blocktrron/serial-hub/serial-hub.kicad_pcb

## KiCad design serial-hub.kicad_pcb (2023-05-25)

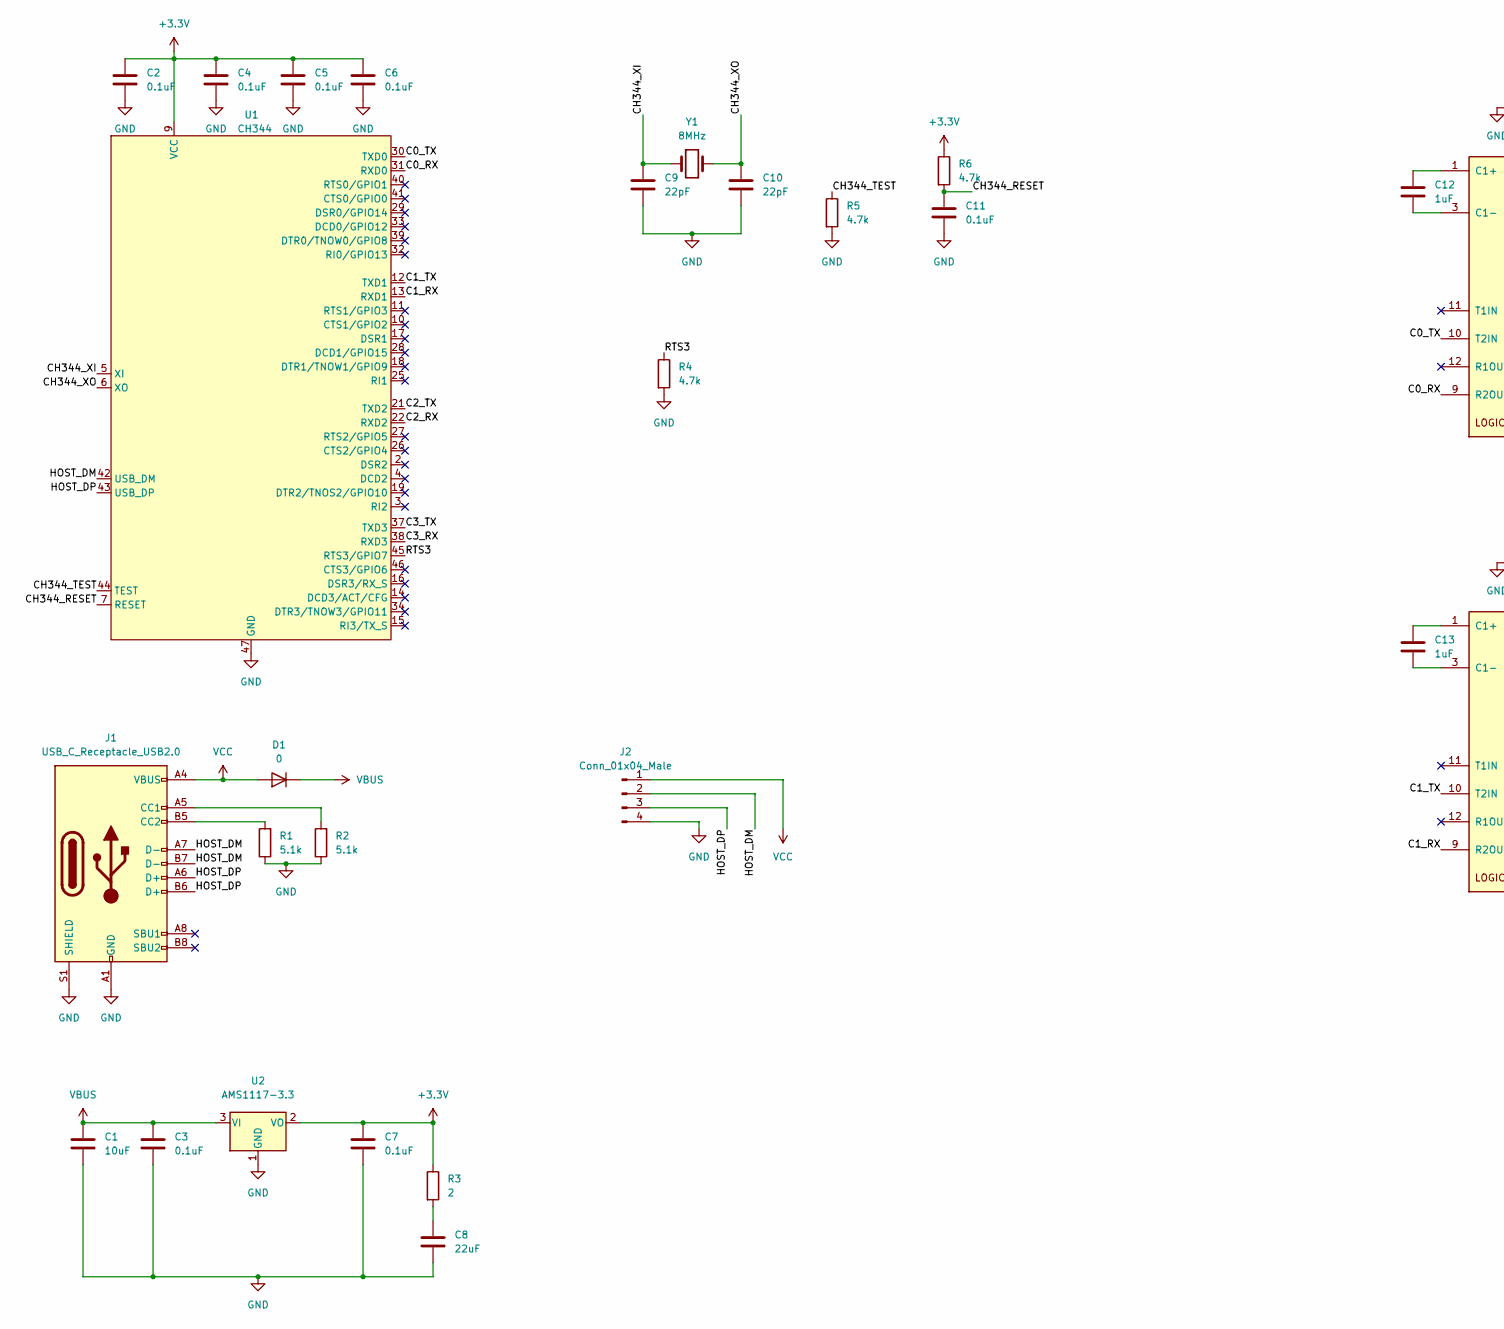
[picture p1: schematic serial-hub.kicad_sch, part in row 1, column 1]

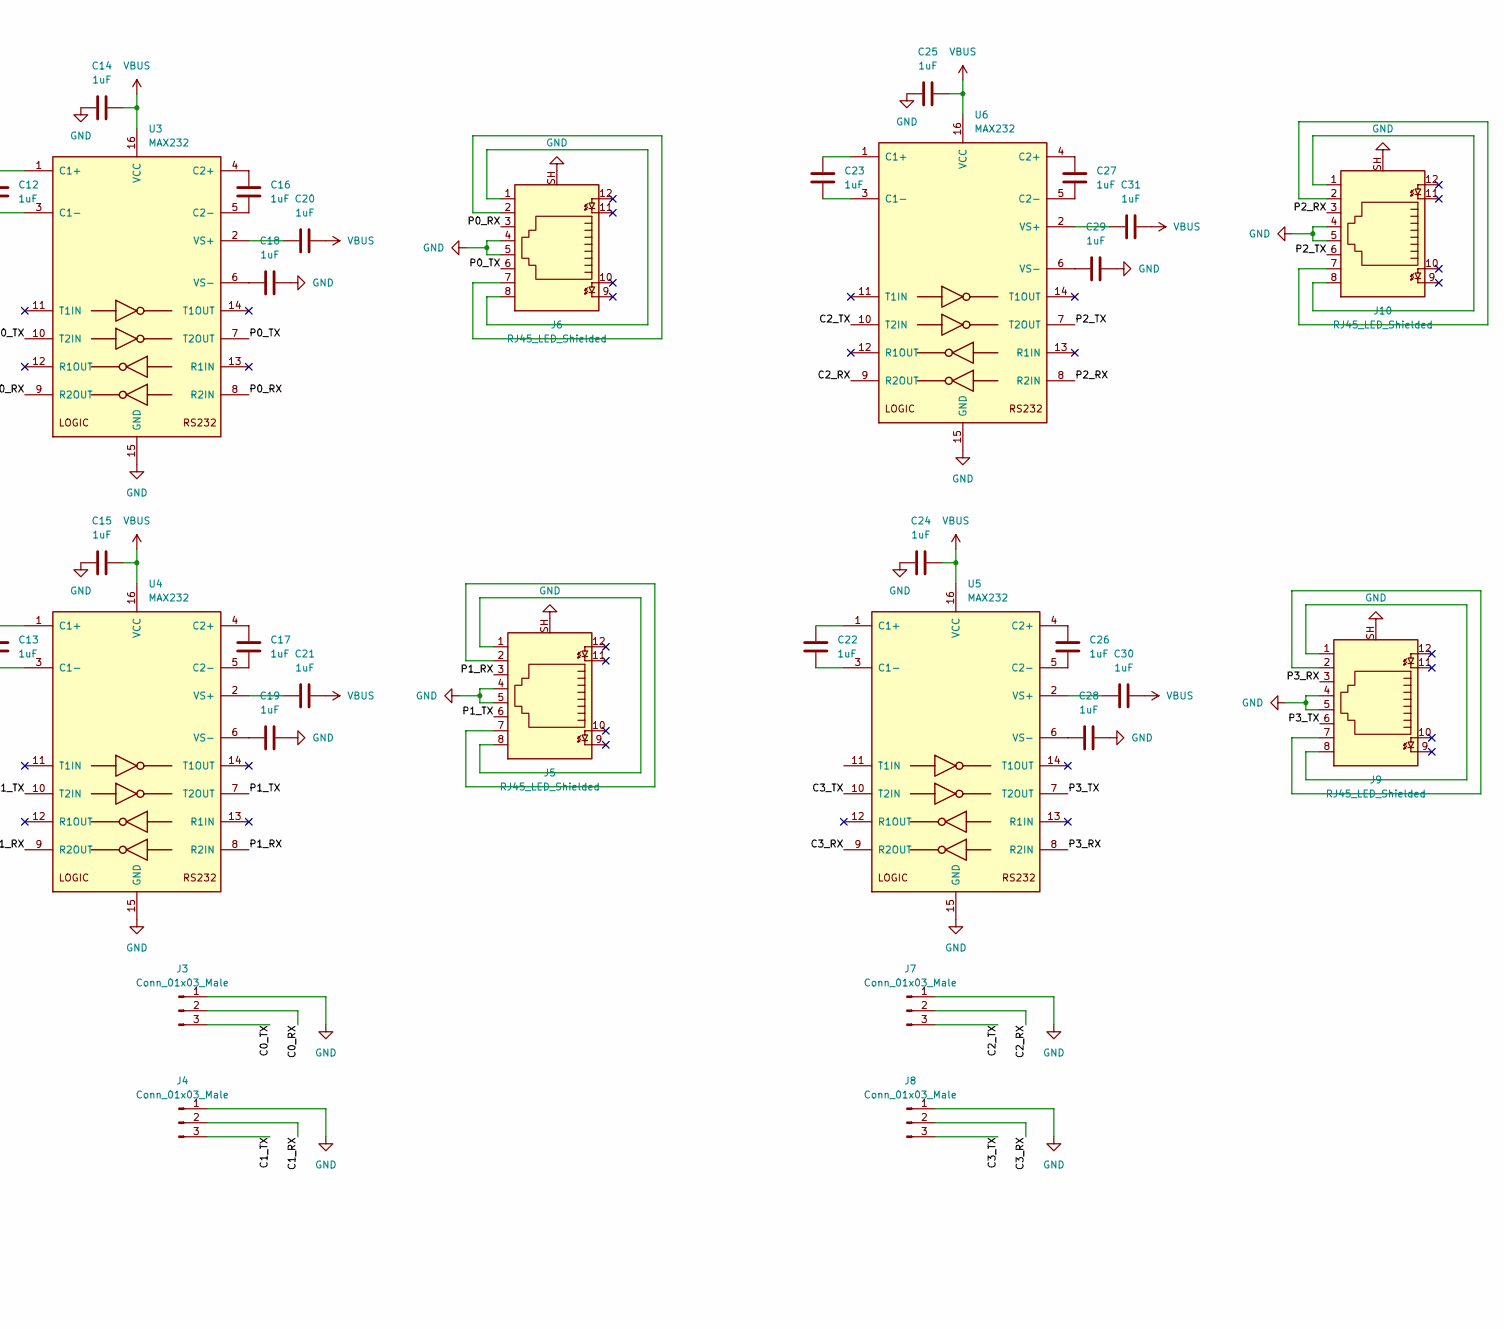
[picture p2: schematic serial-hub.kicad_sch, part in row 1, column 2]

Parts:
C1: 10uF; C_0603_1608Metric; LCSC C96446
C2, C3, C4, C5, C6, C7, C11: 0.1uF; C_0603_1608Metric; LCSC C14663
C8: 22uF; C_0805_2012Metric; LCSC C45783
C9, C10: 22pF; C_0402_1005Metric; LCSC C1555
C12, C13, C14, C15, C16, C17, C18, C19, C20, C21, C22, C23, C24, C25, C26, C27, C28, C29, C30, C31: 1uF; C_0603_1608Metric; LCSC C15849
D1: 0; D_SOD-123; LCSC C8598
J1: USB_C_Receptacle_USB2.0; USB_C_Receptacle_XKB_U262-16XN-4BVC11; LCSC C2988369
J2: Conn_01x04_Male; PinHeader_1x04_P2.54mm_Vertical
J3, J4, J7, J8: Conn_01x03_Male; PinHeader_1x03_P2.54mm_Vertical
J5, J6, J9, J10: RJ45_LED_Shielded; RJ45_Amphenol_54602-x08_Horizontal; LCSC C2847314
R1, R2: 5.1k; R_0402_1005Metric; LCSC C25905
R3: 2; R_0603_1608Metric; LCSC C22977
R4, R5, R6: 4.7k; R_0402_1005Metric; LCSC C25900
U1: CH344; LQFP-48_7x7mm_P0.5mm; LCSC C2988084
U2: AMS1117-3.3; SOT-223-3_TabPin2; LCSC C6186
U3, U4, U5, U6: MAX232; SOIC-16_3.9x9.9mm_P1.27mm; LCSC C26860
Y1: 8MHz; Crystal_SMD_5032-2Pin_5.0x3.2mm; LCSC C115962

Connections:
+3.3V: C2.1, C4.1, C5.1, C6.1, C7.1, R3.1, R6.1, U1.9 (VCC), U1.24 (VCC), U1.36 (VCC), U1.48 (VCC), U2.2 (VO)
/C0_RX: J3.2, U1.31 (RXD0), U3.9 (R2OUT)
/C0_TX: J3.3, U1.30 (TXD0), U3.10 (T2IN)
/C1_RX: J4.2, U1.13 (RXD1), U4.9 (R2OUT)
/C1_TX: J4.3, U1.12 (TXD1), U4.10 (T2IN)
/C2_RX: J7.2, U1.22 (RXD2), U6.9 (R2OUT)
/C2_TX: J7.3, U1.21 (TXD2), U6.10 (T2IN)
/C3_RX: J8.2, U1.38 (RXD3), U5.9 (R2OUT)
/C3_TX: J8.3, U1.37 (TXD3), U5.10 (T2IN)
/CH344_RESET: C11.1, R6.2, U1.7 (RESET)
/CH344_TEST: R5.1, U1.44 (TEST)
/CH344_XI: C9.1, U1.5 (XI), Y1.1
/CH344_XO: C10.1, U1.6 (XO), Y1.2
/HOST_DM: J1.A7 (D-), J1.B7 (D-), J2.2, U1.42 (USB_DM)
/HOST_DP: J1.A6 (D+), J1.B6 (D+), J2.3, U1.43 (USB_DP)
/P0_RX: J6.3, U3.8 (R2IN)
/P0_TX: J6.6, U3.7 (T2OUT)
/P1_RX: J5.3, U4.8 (R2IN)
/P1_TX: J5.6, U4.7 (T2OUT)
/P2_RX: J10.3, U6.8 (R2IN)
/P2_TX: J10.6, U6.7 (T2OUT)
/P3_RX: J9.3, U5.8 (R2IN)
/P3_TX: J9.6, U5.7 (T2OUT)
/RTS3: R4.1, U1.45 (RTS3/GPIO7)
GND: C1.2, C2.2, C3.2, C4.2, C5.2, C6.2, C7.2, C8.2, C9.2, C10.2, C11.2, C14.1, C15.1, C18.2, C19.2, C24.1, C25.1, C28.2, C29.2, J1.A1 (GND), J1.A12 (GND), J1.B1 (GND), J1.B12 (GND), J1.S1 (SHIELD), J2.4, J3.1, J4.1, J5.4, J5.5, J5.SH, J6.4, J6.5, J6.SH, J7.1, J8.1, J9.4, J9.5, J9.SH, J10.4, J10.5, J10.SH, R1.1, R2.1, R4.2, R5.2, U1.8 (GND), U1.20 (GND), U1.23 (GND), U1.35 (GND), U1.47 (GND), U2.1 (GND), U3.15 (GND), U4.15 (GND), U5.15 (GND), U6.15 (GND)
unnamed: C8.1, R3.2
unnamed: C12.1, U3.1 (C1+)
unnamed: C12.2, U3.3 (C1-)
unnamed: C13.1, U4.1 (C1+)
unnamed: C13.2, U4.3 (C1-)
unnamed: C16.1, U3.4 (C2+)
unnamed: C16.2, U3.5 (C2-)
unnamed: C17.1, U4.4 (C2+)
unnamed: C17.2, U4.5 (C2-)
unnamed: C18.1, U3.6 (VS-)
unnamed: C19.1, U4.6 (VS-)
unnamed: C20.1, U3.2 (VS+)
unnamed: C21.1, U4.2 (VS+)
unnamed: C22.1, U5.1 (C1+)
unnamed: C22.2, U5.3 (C1-)
unnamed: C23.1, U6.1 (C1+)
unnamed: C23.2, U6.3 (C1-)
unnamed: C26.1, U5.4 (C2+)
unnamed: C26.2, U5.5 (C2-)
unnamed: C27.1, U6.4 (C2+)
unnamed: C27.2, U6.5 (C2-)
unnamed: C28.1, U5.6 (VS-)
unnamed: C29.1, U6.6 (VS-)
unnamed: C30.1, U5.2 (VS+)
unnamed: C31.1, U6.2 (VS+)
unnamed: J1.A5 (CC1), R2.2
unnamed: J1.B5 (CC2), R1.2
unnamed: J5.1, J5.8
unnamed: J5.2, J5.7
unnamed: J6.1, J6.8
unnamed: J6.2, J6.7
unnamed: J9.1, J9.8
unnamed: J9.2, J9.7
unnamed: J10.1, J10.8
unnamed: J10.2, J10.7
VBUS: C1.1, C3.1, C14.2, C15.2, C20.2, C21.2, C24.2, C25.2, C30.2, C31.2, D1.1 (K), U2.3 (VI), U3.16 (VCC), U4.16 (VCC), U5.16 (VCC), U6.16 (VCC)
VCC: D1.2 (A), J1.A4 (VBUS), J1.A9 (VBUS), J1.B4 (VBUS), J1.B9 (VBUS), J2.1

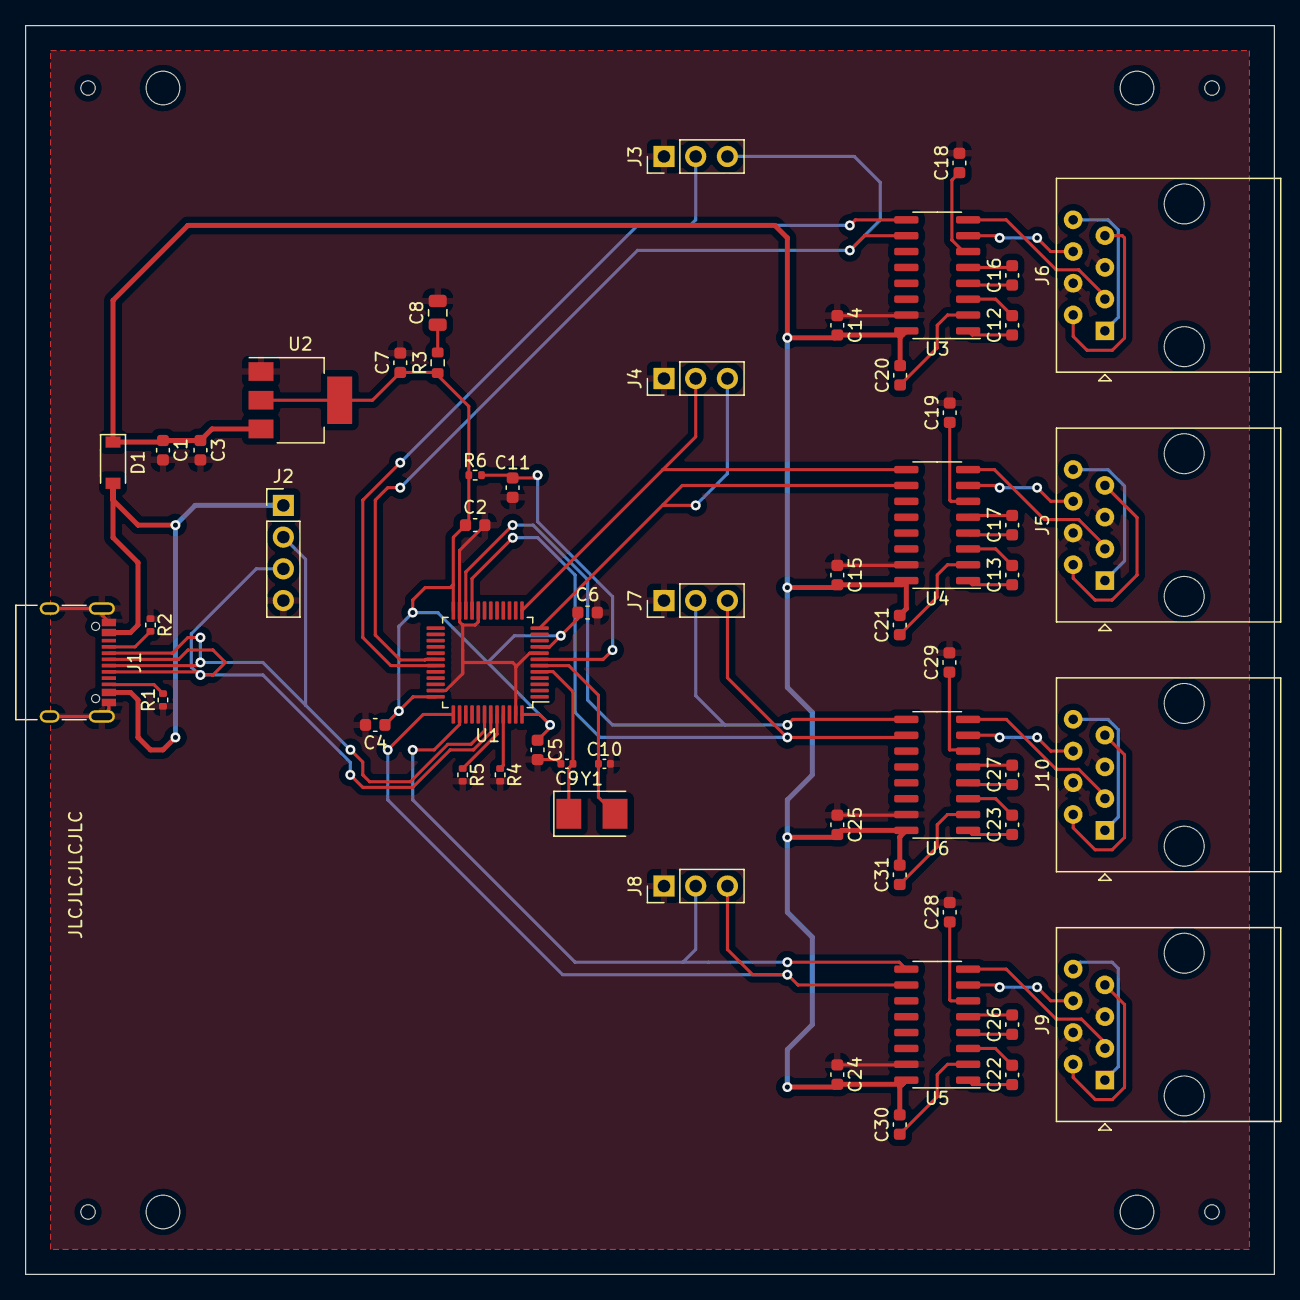
[picture p3: board serial-hub.kicad_pcb from above]

Board: 2 copper layers, 100.0 x 100.0 mm, 55 parts (0 on the bottom side), 62 nets.
