blocktrron/serial-hub/(commit log)

2023-04-21 initial wip
    [serial-hub.kicad_pcb, serial-hub.kicad_sch]
2023-04-23 init pcb design
    [serial-hub.kicad_pcb, serial-hub.kicad_sch]
2023-04-23 fix max232 caps
    [serial-hub.kicad_sch]
2023-04-23 update schematic
    [serial-hub.kicad_sch]
2023-04-23 update sch
    [serial-hub.kicad_sch]
2023-04-23 update PCB
    [serial-hub.kicad_pcb, serial-hub.kicad_sch]
2023-04-23 fix USB-C part number
    [serial-hub.kicad_sch]
2023-04-23 add LCSC ids to pcb
    [serial-hub.kicad_pcb]
2023-04-23 add test-pins for UART
    [serial-hub.kicad_pcb, serial-hub.kicad_sch]
2023-04-23 switch USB-C / add CH344 input caps
    [serial-hub.kicad_pcb, serial-hub.kicad_sch]
2023-04-24 add mounting holes
    [serial-hub.kicad_pcb]
2023-04-24 lock mounting holes
    [serial-hub.kicad_pcb]
2023-05-10 gitignore: add old schematic
2023-05-10 schematic: fix incorrect JLC part assignment
    [serial-hub.kicad_sch]
2023-05-25 board: fix wrong RJ45 pins
    [serial-hub.kicad_pcb, serial-hub.kicad_sch]
